dodomasek/GrowBox-Automation-Project/etc/GrowBox_CLI.jpg

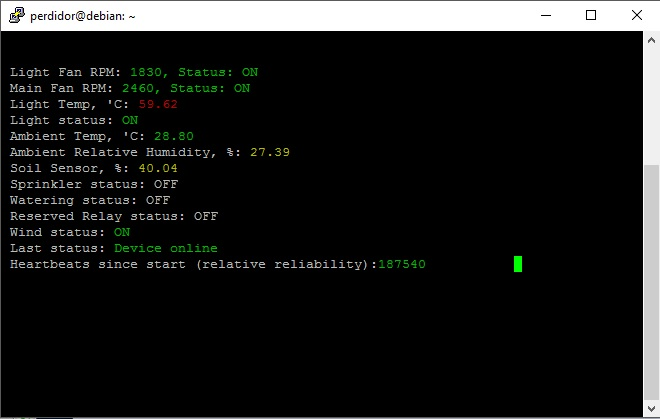
etc/GrowBox_CLI.jpg
