dodomasek/GrowBox-Automation-Project/etc/PCB.JPG

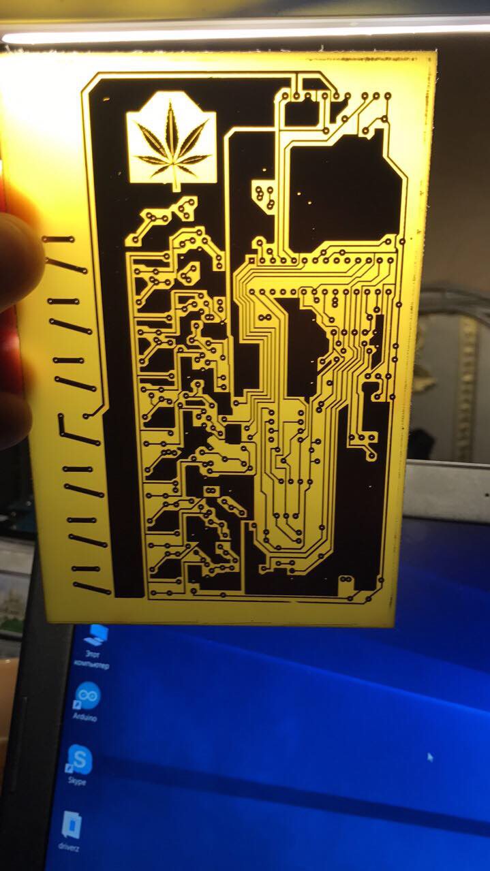
etc/PCB.JPG
