dodomasek/GrowBox-Automation-Project/PCB/cannabis-leaf-black-silhouette.bmp

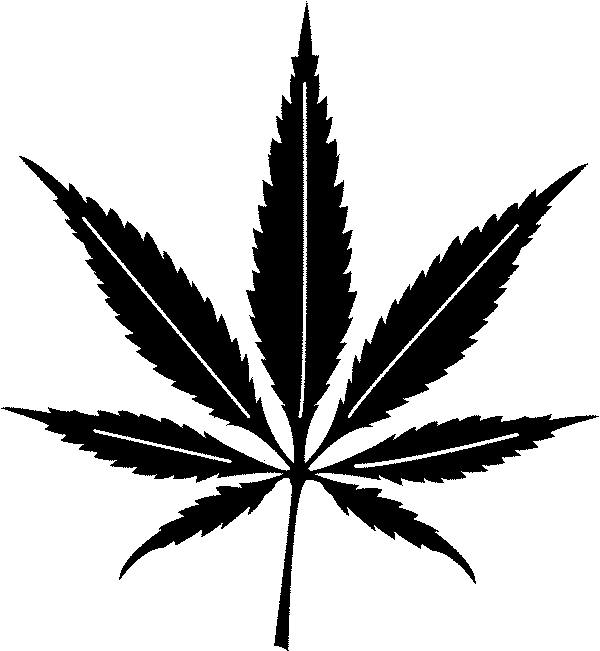
PCB/cannabis-leaf-black-silhouette.bmp
