dodomasek/GrowBox-Automation-Project/(list of files, drawings)

Other design files:
PCB/GrowBox.lay
PCB/GrowBox_VGA2IIC.lay
